OlegMishin/A500_8MB_ide/Doc/IMG_6086.jpg

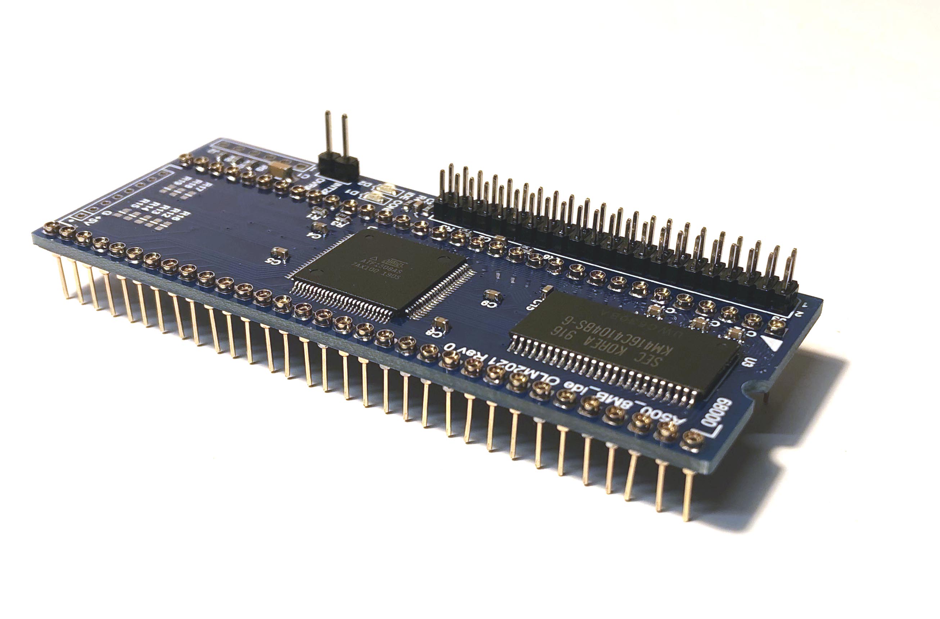
Doc/IMG_6086.jpg
