OlegMishin/A500_8MB_ide/Doc/IMG_6087.jpg

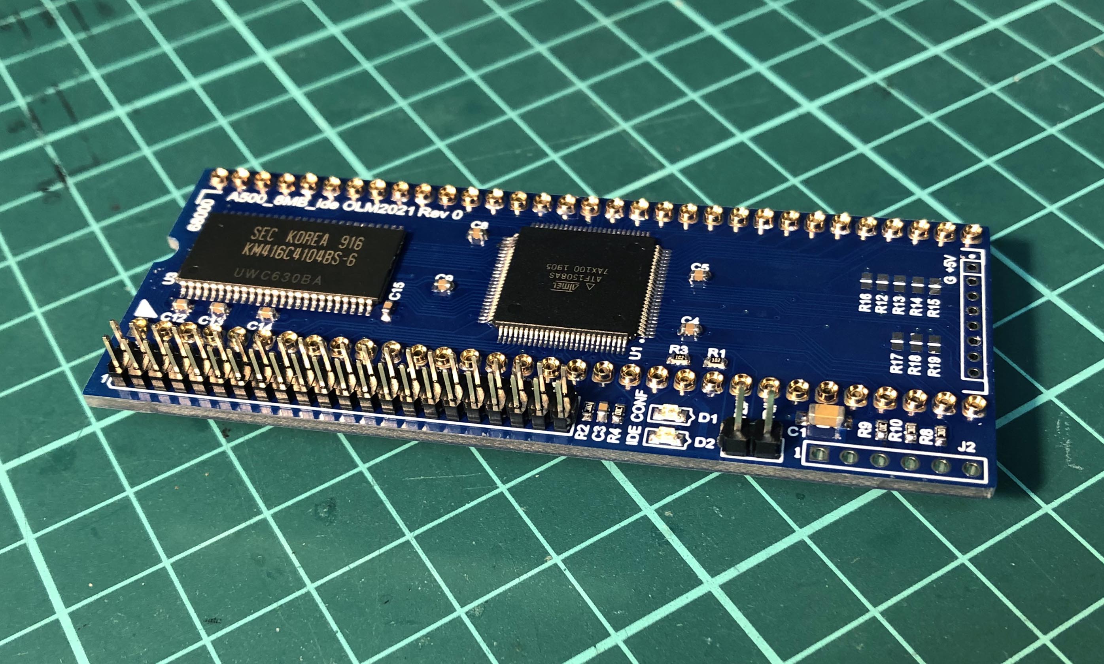
Doc/IMG_6087.jpg
