OlegMishin/A500_8MB_ide/Doc/3D_render.png

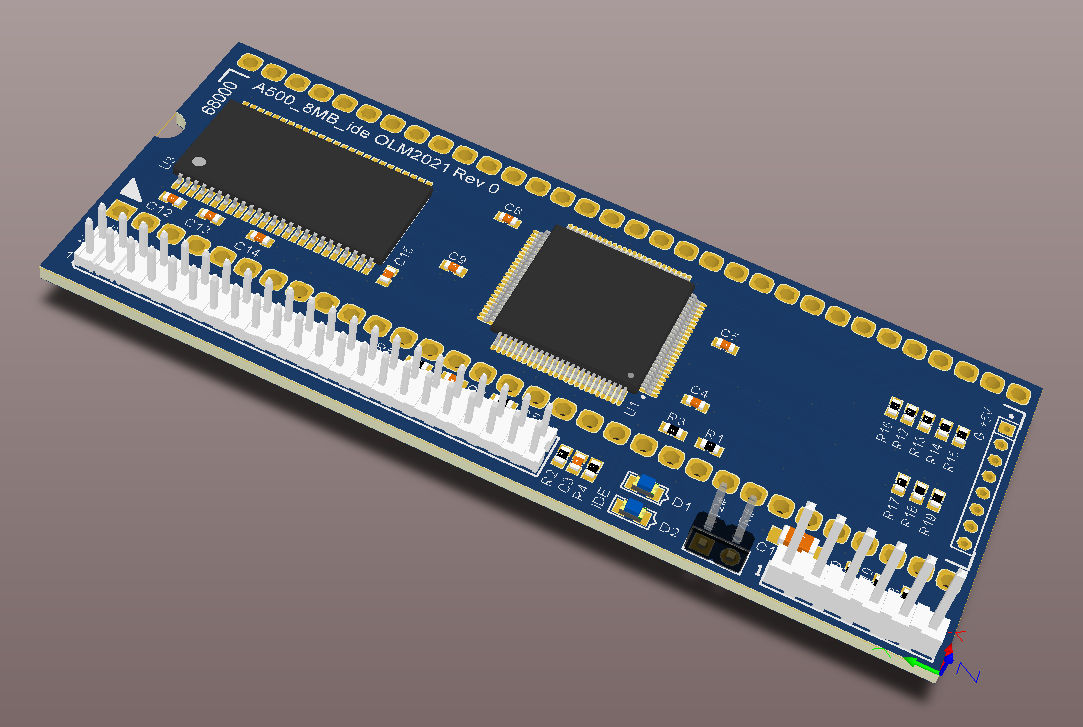
Doc/3D_render.png
