OlegMishin/A500_8MB_ide/Doc/IMG_5418.JPG

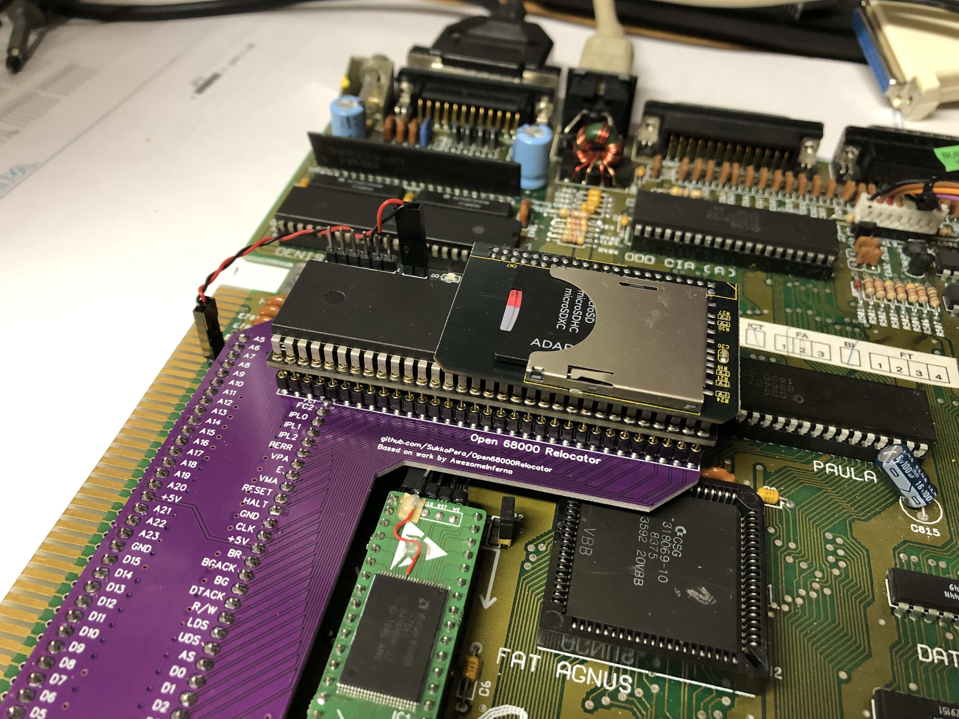
Doc/IMG_5418.JPG
