OlegMishin/A500_8MB_ide/Doc/IMG_5419.JPG

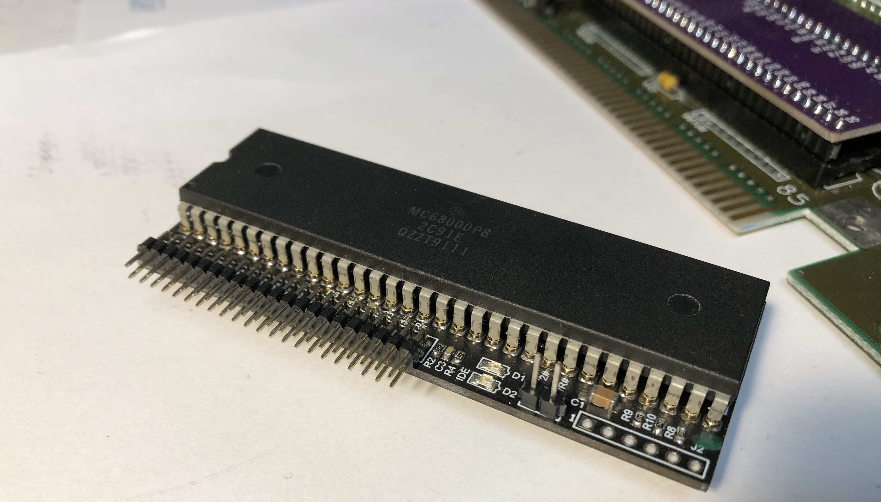
Doc/IMG_5419.JPG
