OlegMishin/A500_8MB_ide/Doc/IMG_5420.JPG

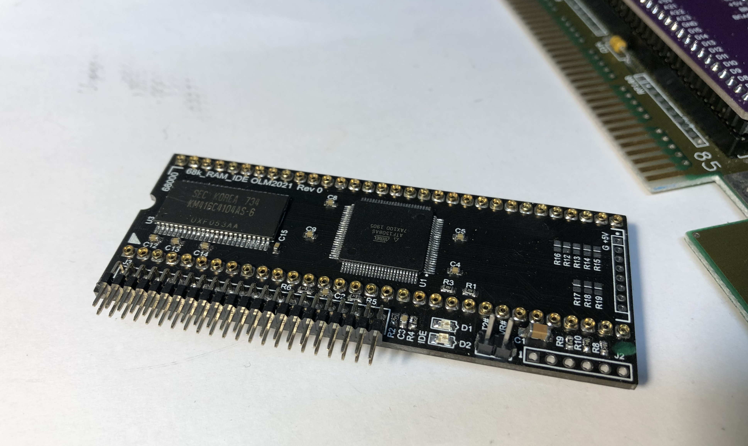
Doc/IMG_5420.JPG
