OlegMishin/A500_8MB_ide/pcb-rev0/A500_8MB_ide_rev0_BOM.PDF

Bill of Materials | A500_8MB_ide.PrjPcb
Revision | 0.0
Creation date | 15.10.2021 | 12:38:57
Print date | 15.10.2021 | 12:39:03
N п.п. | Quantity | Designator | #Column Name Error:Comment Value | | Description
1 | 1 | C1 | | 10uF 1206 | Ceramic capacitor SMD
2 | 14 | C2, C3, C4, C5, C6, C7, C8, C9, C10, C11, C12, C13, C14, C15 | | 100nF 0603 | Ceramic capacitor SMD
3 | 1 | D1 | | APTD3216MGC | LED Green
4 | 1 | D2 | | APTD3216EC | LED Red
5 | 1 | J1 | | Socket 1-pin x 64 | 64 combined socket/pins
6 | 1 | J2 | | PLS2-6 | Header, 6-Pin, 2mm pitch
7 | 1 | J3 | | PLD2-44 | Header, 22-Pin, Dual row, 2mm pitch
8 | 1 | J4 | | PLS-2 | Header, 2-Pin, 2.54mm pitch
9 | 1 | J5 | | PLS2-8 | Header, 8-Pin, 2mm pitch
10 2 | | R1, R3 | | 470 0603 | Resistor
11 7 | | R2, R4, R5, R6, R8, R9, R10 | | 10k 0603 | Resistor
12 2 | | R7, R11 | | 0R 0603 | Resistor (Jumper)
13 1 | | U1 | | ATF1508AS-7AX100 | 128 macrocells CPLD
14 1 | | U3 | | KM416C4104C | 4Mx16 EDO DRAM TSOP-II-50
