OlegMishin/A500_8MB_ide/(threads)

Thread 1 (2021-12-03):

Gerber

ozkanocakli, 2021-12-03:
Is there any chance to get Gerber files, I could not open cam file

best reagrds

OlegMishin, 2021-12-03:
Hi,
the Gerbers have been added to "pcb_rev0" folder.
BR,
Oleg

Closed 2021-12-03.

Thread 2 (2022-04-09):

Amiga 2000 Support?

salocinx, 2022-04-09:
Hi

Thanks for sharing this amazing project!

Does "no support for CFGIN/CFGOUT" mean it will conflict with other Zorro II Autoconfig boards in an Amiga 2000?

Regards
Nicolas

OlegMishin, 2022-04-09:
Hi Nicolas,

Thats right. As  have only A500, I had no chance to test other Autoconfig gevices.
But it is quite easy to route CFGOUT to one of the test pins, so the board can be first in a chain.

Cheers
Oleg

Thread 3 (2022-12-24):

CLPD

hueppee, 2022-12-24:
Hi, I can't find an ATF1508AS-7AX100. Is it possible to use an ATF1508ASL-25AU100 TQFP100 instead, that is the only one I found? Or are there any other IC's that I can use?

OlegMishin, 2022-12-25:
Hello,
In general, ASL-25 should be ok, as the design clocked from CPU's 7MHz. I have never tested it in this project, but in my other similar project "A500-FastRAM-8Mb" I used ASL-25 without any issues.
Based on that, I would recommend to use AS-10 or AS-15 in TQFP100 package (AU100 or AX100 ending) as I tested those speed grades. But ASL-20/25 also should work.

Regards
Oleg

hueppee, 2022-12-30:
Hi, thanks for your answer. I ordered an ATF1508AS-10AU100. Now I have a question, how I have to program the CPLD. On your board there are two connectors without labels. I labeled the JTAG connector, see the attached picture. Is that correct?
And how can I program the CPLD?
Here I found a description
[https://github.com/SukkoPera/OpenAmiga500FastRamExpansion/tree/master/firmware](https://github.com/SukkoPera/OpenAmiga500FastRamExpansion/tree/master/firmware)
Using a USB Blaster clone.
Or is it possible to use a raspberry pi? Which is done here for XC95xxXL CPLD's.
[https://github.com/LIV2/Bluster/blob/master/Programming.md](https://github.com/LIV2/Bluster/blob/master/Programming.md)

Best regards
Christian
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

OlegMishin, 2022-12-30:
Hi Christian,
Please refer to circuit diagram for actual JTAG pinout. It is on J2 as you found, but the pinout on your picture is not matching the circuit.
It should be:
1 - VCC
2 - TDO
3 - TCK
4 - TMS
5 - TDI
6 - GND
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

There are many ways for flashing the firmware. I use **Altera USB blaster** as below and OpenOCD software:
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

https://openocd.org/pages/getting-openocd.html

Just install OpenOCD and use this command to flash. It shall be executed in folder where *.svf firmware is located:
**"E:\openocd-v0.11.0\bin\openocd.exe" -f "E:\openocd-v0.11.0\scripts\interface\altera-usb-blaster.cfg" -c init -c "svf A500_8mb_ide.svf" -c "sleep 200" -c shutdown**
In my case OpenOCD installed in "E:\openocd-v0.11.0".

Regards
Oleg

rmueller83, 2023-01-14:
@hueppee did you have success?
I found some examples of using OpenOCD with a Raspberry here:
https://iosoft.blog/2019/01/28/raspberry-pi-openocd/
https://blog.wokwi.com/gdb-debugging-esp32-using-raspberry-pi/

OlegMishin, 2023-01-14:
I have never tried Raspberry as a debugger/loader cable.  As I have USB blaster, which is really cheap, no need for me to use anything else.
As an alternative FTDI FT232 adapter also should work.
Please check this article: https://www.hackup.net/2020/01/erasing-and-programming-the-atf1504-cpld/

hueppee, 2023-01-15:
Thanks for your answer! I ordered an USB blaster. Due to lack of time I will probably continue to solder the pcb in 2 weeks. I will report if everything works fine.

Best regards

Christian

hueppee, 2023-01-28:
Hi Oleg, my "USB Blaster" arrived and I installed openocd. But I have a problem to flash the  ATF1508AS.

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

Here the output of OpenOCD:

[out.txt](https://github.com/OlegMishin/A500_8MB_ide/files/10528406/out.txt)

OlegMishin, 2023-01-29:
Hi Christian,
There are some points in your assembly, which are not critical, but just to pay attention to:- First of all, the chip itself looks like counterfeit. The marking is different to chips I have (ordered at Mouser and Digikey). Have a look at the attached photo.- Not all decoupling capacitors are mounted. It is not critical for programming, but for normal operation it is mandatory to mount all of them.
USBblaster connection looks ok, but how do you supply the board? The USBblaster does not provide target supply voltage. In my setup I use an external power supply(red/black twisted wires on my photo). Please confirm, the board is powered. If no external power is applied, I got the same errors as you.
I have attached successful  CPLD programming log for your reference.
RegardsOleg

    On Saturday, January 28, 2023 at 11:25:08 PM GMT+1, hueppee ***@***.***> wrote:

Hi Oleg, my "USB Blaster" arrived and I installed openocd. But I have a problem to flash the ATF1508AS.

Here the output of OpenOCD:

out.txt

—
Reply to this email directly, view it on GitHub, or unsubscribe.
You are receiving this because you commented.Message ID: ***@***.***>

U:\work\Amiga\A500\A500_8MB_ide\firmware\rev1\output_files>rem bin-x64\openocd.exe -f scripts\interface\ftdi\um232h.cfg -c "adapter_khz 400" -c "transport select jtag" -c "jtag newtap ATF1504AS tap -irlen 3 -expected-id 0x0150403f" -c init -c "svf VC20FINAL-V3-2.svf" -c "sleep 200" -c shutdown

U:\work\Amiga\A500\A500_8MB_ide\firmware\rev1\output_files>"E:\openocd-v0.11.0\bin\openocd.exe" -f "E:\openocd-v0.11.0\scripts\interface\altera-usb-blaster.cfg" -c init -c "svf A500_8mb_ide.svf" -c "sleep 200" -c shutdown
Open On-Chip Debugger 0.11.0 (2021-03-07-12:52)
Licensed under GNU GPL v2
For bug reports, read
        http://openocd.org/doc/doxygen/bugs.html
Info : only one transport option; autoselect 'jtag'
Info : usb blaster interface using libftdi
Error: unable to get latency timer
Info : This adapter doesn't support configurable speed
Warn : There are no enabled taps.  AUTO PROBING MIGHT NOT WORK!!
Info : JTAG tap: auto0.tap tap/device found: 0x0150803f (mfg: 0x01f (Atmel), part: 0x1508, ver: 0x0)
Warn : AUTO auto0.tap - use "jtag newtap auto0 tap -irlen 3 -expected-id 0x0150803f"
Warn : gdb services need one or more targets defined
svf processing file: "A500_8mb_ide.svf"
TRST ABSENT;
ENDIR IDLE;
ENDDR IDLE;
HDR 0;
HIR 0;
TDR 0;
TIR 0;
RUNTEST 50021E-6 SEC;
STATE RESET;
STATE IDLE;
RUNTEST 50021E-6 SEC;
SIR 10 TDI (280);
SDR 10 TDI (1b9);
STATE IDLE;
SIR 10 TDI (059);
        MASK (ffffffff);
STATE IDLE;
SIR 10 TDI (2b3);
SIR 10 TDI (29e);
STATE IDLE;
RUNTEST 210001E-6 SEC;
SIR 10 TDI (2bf);
STATE IDLE;
STATE RESET;
RUNTEST 50001E-6 SEC;
STATE IDLE;
SIR 10 TDI (280);
SDR 10 TDI (000);
STATE IDLE;
RUNTEST 10001E-6 SEC;
STATE RESET;
RUNTEST 50021E-6 SEC;
RUNTEST 50021E-6 SEC;
STATE RESET;
STATE IDLE;
RUNTEST 50021E-6 SEC;
SIR 10 TDI (280);
SDR 10 TDI (1b9);
STATE IDLE;
SIR 10 TDI (2a1);
SDR 11 TDI (00c);
SIR 10 TDI (290);
SDR 326 TDI (0083234cb204c13add7f0000000000000000000000000000000000000000000000000000000000003f);
SIR 10 TDI (29e);
STATE IDLE;
RUNTEST 30001E-6 SEC;
SIR 10 TDI (2bf);
SIR 10 TDI (2a1);
SDR 11 TDI (00d);
SIR 10 TDI (290);
SDR 326 TDI (0083234cb204c13add7f0000000000000000000000000000000000000000000000000000000000003f);
SIR 10 TDI (29e);
STATE IDLE;
RUNTEST 30001E-6 SEC;
SIR 10 TDI (2bf);
SIR 10 TDI (2a1);
SDR 11 TDI (00e);
SIR 10 TDI (290);
SDR 326 TDI (0087234cf204c13bdf7f8000000000000000000000000000000000000000000000000000000000003f);
SIR 10 TDI (29e);
STATE IDLE;
RUNTEST 30001E-6 SEC;
SIR 10 TDI (2bf);
SIR 10 TDI (2a1);
SDR 11 TDI (00f);
SIR 10 TDI (290);
SDR 326 TDI (0087234cf204c13bdf7f8000000000000000000000000000000000000000000000000000000000003f);
SIR 10 TDI (29e);
STATE IDLE;
RUNTEST 30001E-6 SEC;
SIR 10 TDI (2bf);
SIR 10 TDI (2a1);
SDR 11 TDI (010);
SIR 10 TDI (290);
SDR 326 TDI (0087234cf204c13bdf7f8000000000000000000000000000000000000000000000000000000000003f);
SIR 10 TDI (29e);
STATE IDLE;
RUNTEST 30001E-6 SEC;
SIR 10 TDI (2bf);
SIR 10 TDI (2a1);
SDR 11 TDI (011);
SIR 10 TDI (290);
SDR 326 TDI (0087234cf204c13bdf7f8000000000000000000000000000000000000000000000000000000000003f);
SIR 10 TDI (29e);
STATE IDLE;
RUNTEST 30001E-6 SEC;
SIR 10 TDI (2bf);
SIR 10 TDI (2a1);
SDR 11 TDI (012);
SIR 10 TDI (290);
SDR 326 TDI (0087234cf204c13bdf7f8000000000000000000000000000000000000000000000000000000000003f);
SIR 10 TDI (29e);
STATE IDLE;
RUNTEST 30001E-6 SEC;
SIR 10 TDI (2bf);
SIR 10 TDI (2a1);
SDR 11 TDI (013);
SIR 10 TDI (290);
SDR 326 TDI (0087234cf204c13bdf7f8000000000000000000000000000000000000000000000000000000000003f);
SIR 10 TDI (29e);
STATE IDLE;
RUNTEST 30001E-6 SEC;
SIR 10 TDI (2bf);
SIR 10 TDI (2a1);
SDR 11 TDI (014);
SIR 10 TDI (290);
SDR 326 TDI (0087234cf204c13bdf7f8000000000000000000000000000000000000000000000000000000000003f);
SIR 10 TDI (29e);
STATE IDLE;
RUNTEST 30001E-6 SEC;
SIR 10 TDI (2bf);
SIR 10 TDI (2a1);
SDR 11 TDI (015);
SIR 10 TDI (290);
SDR 326 TDI (0087234cf204c13bdf7f8000000000000000000000000000000000000000000000000000000000003f);
SIR 10 TDI (29e);
STATE IDLE;
RUNTEST 30001E-6 SEC;
SIR 10 TDI (2bf);
SIR 10 TDI (2a1);
SDR 11 TDI (016);
SIR 10 TDI (290);
SDR 326 TDI (0087234cf204c13bdf7f8000000000000000000000000000000000000000000000000000000000003f);
SIR 10 TDI (29e);
STATE IDLE;
RUNTEST 30001E-6 SEC;
SIR 10 TDI (2bf);
SIR 10 TDI (2a1);
SDR 11 TDI (017);
SIR 10 TDI (290);
SDR 326 TDI (0087234cf204c13bdf7f8000000000000000000000000000000000000000000000000000000000003f);
SIR 10 TDI (29e);
STATE IDLE;
RUNTEST 30001E-6 SEC;
SIR 10 TDI (2bf);
SIR 10 TDI (2a1);
SDR 11 TDI (018);
SIR 10 TDI (290);
SDR 326 TDI (0087234cf204c13bdf7f8000000000000000000000000000000000000000000000000000000000003f);
SIR 10 TDI (29e);
STATE IDLE;
RUNTEST 30001E-6 SEC;
SIR 10 TDI (2bf);
SIR 10 TDI (2a1);
SDR 11 TDI (019);
SIR 10 TDI (290);
SDR 326 TDI (0087234cf204c13bdf7f8000000000000000000000000000000000000000000000000000000000003f);
SIR 10 TDI (29e);
STATE IDLE;
RUNTEST 30001E-6 SEC;
SIR 10 TDI (2bf);
SIR 10 TDI (2a1);
SDR 11 TDI (01a);
SIR 10 TDI (290);
SDR 326 TDI (0087234cf204c13bdf7f8000000000000000000000000000000000000000000000000000000000003f);
SIR 10 TDI (29e);
STATE IDLE;
RUNTEST 30001E-6 SEC;
SIR 10 TDI (2bf);
SIR 10 TDI (2a1);
SDR 11 TDI (01b);
SIR 10 TDI (290);
SDR 326 TDI (0087234cf204c13bdf7f8000000000000000000000000000000000000000000000000000000000003f);
SIR 10 TDI (29e);
STATE IDLE;
RUNTEST 30001E-6 SEC;
SIR 10 TDI (2bf);
SIR 10 TDI (2a1);
SDR 11 TDI (01c);
SIR 10 TDI (290);
SDR 326 TDI (00830244b2044102dd7f0000000000000000000000000000000000000000000000000000000000003f);
SIR 10 TDI (29e);
STATE IDLE;
RUNTEST 30001E-6 SEC;
SIR 10 TDI (2bf);
SIR 10 TDI (2a1);
SDR 11 TDI (01d);
SIR 10 TDI (290);
SDR 326 TDI (0087234cf204c13bdf7f8000000000000000000000000000000000000000000000000000000000003f);
SIR 10 TDI (29e);
STATE IDLE;
RUNTEST 30001E-6 SEC;
SIR 10 TDI (2bf);
SIR 10 TDI (2a1);
SDR 11 TDI (01e);
SIR 10 TDI (290);
SDR 326 TDI (0087234cf204c13bdf7f8000000000000000000000000000000000000000000000000000000000003f);
SIR 10 TDI (29e);
STATE IDLE;
RUNTEST 30001E-6 SEC;
SIR 10 TDI (2bf);
SIR 10 TDI (2a1);
SDR 11 TDI (01f);
SIR 10 TDI (290);
SDR 326 TDI (0087234cf204c13bdf7f8000000000000000000000000000000000000000000000000000000000003f);
SIR 10 TDI (29e);
STATE IDLE;
RUNTEST 30001E-6 SEC;
SIR 10 TDI (2bf);
SIR 10 TDI (2a1);
SDR 11 TDI (020);
SIR 10 TDI (290);
SDR 326 TDI (0087234cf204c13bdf7f8000000000000000000000000000000000000000000000000000000000003f);
SIR 10 TDI (29e);
STATE IDLE;
RUNTEST 30001E-6 SEC;
SIR 10 TDI (2bf);
SIR 10 TDI (2a1);
SDR 11 TDI (021);
SIR 10 TDI (290);
SDR 326 TDI (0087234cf204c13bdf7f8000000000000000000000000000000000000000000000000000000000003f);
SIR 10 TDI (29e);
STATE IDLE;
RUNTEST 30001E-6 SEC;
SIR 10 TDI (2bf);
SIR 10 TDI (2a1);
SDR 11 TDI (022);
SIR 10 TDI (290);
SDR 326 TDI (0087234cf204c13bdf7f8000000000000000000000000000000000000000000000000000000000003f);
SIR 10 TDI (29e);
STATE IDLE;
RUNTEST 30001E-6 SEC;
SIR 10 TDI (2bf);
SIR 10 TDI (2a1);
SDR 11 TDI (023);
SIR 10 TDI (290);
SDR 326 TDI (0087234cf204c13bdf7f8000000000000000000000000000000000000000000000000000000000003f);
SIR 10 TDI (29e);
STATE IDLE;
RUNTEST 30001E-6 SEC;
SIR 10 TDI (2bf);
SIR 10 TDI (2a1);
SDR 11 TDI (024);
SIR 10 TDI (290);
SDR 326 TDI (0087214cf204c03bdf5e8000000000000000000000000000000000000000000000000000000000003f);
SIR 10 TDI (29e);
STATE IDLE;
RUNTEST 30001E-6 SEC;
SIR 10 TDI (2bf);
SIR 10 TDI (2a1);
SDR 11 TDI (025);
SIR 10 TDI (290);
SDR 326 TDI (0087234cf204c13bdf7d8000000000000000000000000000000000000000000000000000000000003f);
SIR 10 TDI (29e);
STATE IDLE;
RUNTEST 30001E-6 SEC;
SIR 10 TDI (2bf);
SIR 10 TDI (2a1);
SDR 11 TDI (026);
SIR 10 TDI (290);
SDR 326 TDI (0084224c4204c139127f8000000000000000000000000000000000000000000000000000000000003f);
SIR 10 TDI (29e);
STATE IDLE;
RUNTEST 30001E-6 SEC;
SIR 10 TDI (2bf);
SIR 10 TDI (2a1);
SDR 11 TDI (027);
SIR 10 TDI (290);
SDR 326 TDI (0087034cf204c13bdf0c8000000000000000000000000000000000000000000000000000000000003f);
SIR 10 TDI (29e);
STATE IDLE;
RUNTEST 30001E-6 SEC;
SIR 10 TDI (2bf);
SIR 10 TDI (2a1);
SDR 11 TDI (028);
SIR 10 TDI (290);
SDR 326 TDI (00830244b2044112dd7f0000000000000000000000000000000000000000000000000000000000003f);
SIR 10 TDI (29e);
STATE IDLE;
RUNTEST 30001E-6 SEC;
SIR 10 TDI (2bf);
SIR 10 TDI (2a1);
SDR 11 TDI (029);
SIR 10 TDI (290);
SDR 326 TDI (0087234cf204c13bdf7f8000000000000000000000000000000000000000000000000000000000003f);
SIR 10 TDI (29e);
STATE IDLE;
RUNTEST 30001E-6 SEC;
SIR 10 TDI (2bf);
SIR 10 TDI (2a1);
SDR 11 TDI (02a);
SIR 10 TDI (290);
SDR 326 TDI (00830244b2044102dd7f0000000000000000000000000000000000000000000000000000000000003f);
SIR 10 TDI (29e);
STATE IDLE;
RUNTEST 30001E-6 SEC;
SIR 10 TDI (2bf);
SIR 10 TDI (2a1);
SDR 11 TDI (02b);
SIR 10 TDI (290);
SDR 326 TDI (0087234cf204c13bdf7f8000000000000000000000000000000000000000000000000000000000003f);
SIR 10 TDI (29e);
STATE IDLE;
RUNTEST 30001E-6 SEC;
SIR 10 TDI (2bf);
SIR 10 TDI (2a1);
SDR 11 TDI (02c);
SIR 10 TDI (290);
SDR 326 TDI (0007214cf204c13bdf6f8000000000000000000000000000000000000000000000000000000000003f);
SIR 10 TDI (29e);
STATE IDLE;
RUNTEST 30001E-6 SEC;
SIR 10 TDI (2bf);
SIR 10 TDI (2a1);
SDR 11 TDI (02d);
SIR 10 TDI (290);
SDR 326 TDI (0087234cf204c13bdf7f8000000000000000000000000000000000000000000000000000000000003f);
SIR 10 TDI (29e);
STATE IDLE;
RUNTEST 30001E-6 SEC;
SIR 10 TDI (2bf);
SIR 10 TDI (2a1);
SDR 11 TDI (02e);
SIR 10 TDI (290);
SDR 326 TDI (0087234cf204c13bdf7f8000000000000000000000000000000000000000000000000000000000003f);
SIR 10 TDI (29e);
STATE IDLE;
RUNTEST 30001E-6 SEC;
SIR 10 TDI (2bf);
SIR 10 TDI (2a1);
SDR 11 TDI (02f);
SIR 10 TDI (290);
SDR 326 TDI (0087234cf200c13bdf7f8000000000000000000000000000000000000000000000000000000000003f);
SIR 10 TDI (29e);
STATE IDLE;
RUNTEST 30001E-6 SEC;
SIR 10 TDI (2bf);
SIR 10 TDI (2a1);
SDR 11 TDI (030);
SIR 10 TDI (290);
SDR 326 TDI (0087234cf204c13bdf7f8000000000000000000000000000000000000000000000000000000000003f);
SIR 10 TDI (29e);
STATE IDLE;
RUNTEST 30001E-6 SEC;
SIR 10 TDI (2bf);
SIR 10 TDI (2a1);
SDR 11 TDI (031);
SIR 10 TDI (290);
SDR 326 TDI (0087234cf004c13bdf7f8000000000000000000000000000000000000000000000000000000000003f);
SIR 10 TDI (29e);
STATE IDLE;
RUNTEST 30001E-6 SEC;
SIR 10 TDI (2bf);
SIR 10 TDI (2a1);
SDR 11 TDI (032);
SIR 10 TDI (290);
SDR 326 TDI (0085234c7204c13bdf7f8000000000000000000000000000000000000000000000000000000000003f);
SIR 10 TDI (29e);
STATE IDLE;
RUNTEST 30001E-6 SEC;
SIR 10 TDI (2bf);
SIR 10 TDI (2a1);
SDR 11 TDI (033);
SIR 10 TDI (290);
SDR 326 TDI (0086234ce204c13bdf7f8000000000000000000000000000000000000000000000000000000000003f);
SIR 10 TDI (29e);
STATE IDLE;
RUNTEST 30001E-6 SEC;
SIR 10 TDI (2bf);
SIR 10 TDI (2a1);
SDR 11 TDI (034);
SIR 10 TDI (290);
SDR 326 TDI (0087234cf204c13bdf7f8000000000000000000000000000000000000000000000000000000000003f);
SIR 10 TDI (29e);
STATE IDLE;
RUNTEST 30001E-6 SEC;
SIR 10 TDI (2bf);
SIR 10 TDI (2a1);
SDR 11 TDI (035);
SIR 10 TDI (290);
SDR 326 TDI (0087234cf204c13bdf7f8000000000000000000000000000000000000000000000000000000000003f);
SIR 10 TDI (29e);
STATE IDLE;
RUNTEST 30001E-6 SEC;
SIR 10 TDI (2bf);
SIR 10 TDI (2a1);
SDR 11 TDI (036);
SIR 10 TDI (290);
SDR 326 TDI (0087234cf204c13bdf7f8000000000000000000000000000000000000000000000000000000000003f);
SIR 10 TDI (29e);
STATE IDLE;
RUNTEST 30001E-6 SEC;
SIR 10 TDI (2bf);
SIR 10 TDI (2a1);
SDR 11 TDI (037);
SIR 10 TDI (290);
SDR 326 TDI (0083224cb204c13add7f0000000000000000000000000000000000000000000000000000000000003f);
SIR 10 TDI (29e);
STATE IDLE;
RUNTEST 30001E-6 SEC;
SIR 10 TDI (2bf);
SIR 10 TDI (2a1);
SDR 11 TDI (038);
SIR 10 TDI (290);
SDR 326 TDI (0087234cf204c13bda4f8000000000000000000000000000000000000000000000000000000000003f);
SIR 10 TDI (29e);
STATE IDLE;
RUNTEST 30001E-6 SEC;
SIR 10 TDI (2bf);
SIR 10 TDI (2a1);
SDR 11 TDI (039);
SIR 10 TDI (290);
SDR 326 TDI (0087234cf204c13bcf7f8000000000000000000000000000000000000000000000000000000000003f);
SIR 10 TDI (29e);
STATE IDLE;
RUNTEST 30001E-6 SEC;
SIR 10 TDI (2bf);
SIR 10 TDI (2a1);
SDR 11 TDI (03a);
SIR 10 TDI (290);
SDR 326 TDI (0084234c4204c139167b8000000000000000000000000000000000000000000000000000000000003f);
SIR 10 TDI (29e);
STATE IDLE;
RUNTEST 30001E-6 SEC;
SIR 10 TDI (2bf);
SIR 10 TDI (2a1);
SDR 11 TDI (03b);
SIR 10 TDI (290);
SDR 326 TDI (00870244f2044123db048000000000000000000000000000000000000000000000000000000000003f);
SIR 10 TDI (29e);
STATE IDLE;
RUNTEST 30001E-6 SEC;
SIR 10 TDI (2bf);
SIR 10 TDI (2a1);
SDR 11 TDI (03c);
SIR 10 TDI (290);
SDR 326 TDI (0087234cf204c12bdf7f8000000000000000000000000000000000000000000000000000000000003f);
SIR 10 TDI (29e);
STATE IDLE;
RUNTEST 30001E-6 SEC;
SIR 10 TDI (2bf);
SIR 10 TDI (2a1);
SDR 11 TDI (03d);
SIR 10 TDI (290);
SDR 326 TDI (00830244b204411add7f0000000000000000000000000000000000000000000000000000000000003f);
SIR 10 TDI (29e);
STATE IDLE;
RUNTEST 30001E-6 SEC;
SIR 10 TDI (2bf);
SIR 10 TDI (2a1);
SDR 11 TDI (03e);
SIR 10 TDI (290);
SDR 326 TDI (0087234cf204c13bdf7f8000000000000000000000000000000000000000000000000000000000003f);
SIR 10 TDI (29e);
STATE IDLE;
RUNTEST 30001E-6 SEC;
SIR 10 TDI (2bf);
SIR 10 TDI (2a1);
SDR 11 TDI (03f);
SIR 10 TDI (290);
SDR 326 TDI (00830244b2044102dd7f0000000000000000000000000000000000000000000000000000000000003f);
SIR 10 TDI (29e);
STATE IDLE;
RUNTEST 30001E-6 SEC;
SIR 10 TDI (2bf);
SIR 10 TDI (2a1);
SDR 11 TDI (040);
SIR 10 TDI (290);
SDR 326 TDI (0087234cf204c13bdf7f8000000000000000000000000000000000000000000000000000000000003f);
SIR 10 TDI (29e);
STATE IDLE;
RUNTEST 30001E-6 SEC;
SIR 10 TDI (2bf);
SIR 10 TDI (2a1);
SDR 11 TDI (041);
SIR 10 TDI (290);
SDR 326 TDI (0087234cf204c13bdf7f8000000000000000000000000000000000000000000000000000000000003f);
SIR 10 TDI (29e);
STATE IDLE;
RUNTEST 30001E-6 SEC;
SIR 10 TDI (2bf);
SIR 10 TDI (2a1);
SDR 11 TDI (042);
SIR 10 TDI (290);
SDR 326 TDI (0087230cf204c03bdb7f8000000000000000000000000000000000000000000000000000000000003f);
SIR 10 TDI (29e);
STATE IDLE;
RUNTEST 30001E-6 SEC;
SIR 10 TDI (2bf);
SIR 10 TDI (2a1);
SDR 11 TDI (043);
SIR 10 TDI (290);
SDR 326 TDI (0087234cf204c13bdf7f8000000000000000000000000000000000000000000000000000000000003f);
SIR 10 TDI (29e);
STATE IDLE;
RUNTEST 30001E-6 SEC;
SIR 10 TDI (2bf);
SIR 10 TDI (2a1);
SDR 11 TDI (044);
SIR 10 TDI (290);
SDR 326 TDI (0087234cf204c1395f7f8000000000000000000000000000000000000000000000000000000000003f);
SIR 10 TDI (29e);
STATE IDLE;
RUNTEST 30001E-6 SEC;
SIR 10 TDI (2bf);
SIR 10 TDI (2a1);
SDR 11 TDI (045);
SIR 10 TDI (290);
SDR 326 TDI (0087234cf204c13b9e7f8000000000000000000000000000000000000000000000000000000000003f);
SIR 10 TDI (29e);
STATE IDLE;
RUNTEST 30001E-6 SEC;
SIR 10 TDI (2bf);
SIR 10 TDI (2a1);
SDR 11 TDI (046);
SIR 10 TDI (290);
SDR 326 TDI (0087234cf204c13bdf7f8000000000000000000000000000000000000000000000000000000000003f);
SIR 10 TDI (29e);
STATE IDLE;
RUNTEST 30001E-6 SEC;
SIR 10 TDI (2bf);
SIR 10 TDI (2a1);
SDR 11 TDI (047);
SIR 10 TDI (290);
SDR 326 TDI (0087234cf204c13bdf7f8000000000000000000000000000000000000000000000000000000000003f);
SIR 10 TDI (29e);
STATE IDLE;
RUNTEST 30001E-6 SEC;
SIR 10 TDI (2bf);
SIR 10 TDI (2a1);
SDR 11 TDI (048);
SIR 10 TDI (290);
SDR 326 TDI (00872344f204413bdf7f8000000000000000000000000000000000000000000000000000000000003f);
SIR 10 TDI (29e);
STATE IDLE;
RUNTEST 30001E-6 SEC;
SIR 10 TDI (2bf);
SIR 10 TDI (2a1);
SDR 11 TDI (049);
SIR 10 TDI (290);
SDR 326 TDI (0087234cf204c13bdf7f8000000000000000000000000000000000000000000000000000000000003f);
SIR 10 TDI (29e);
STATE IDLE;
RUNTEST 30001E-6 SEC;
SIR 10 TDI (2bf);
SIR 10 TDI (2a1);
SDR 11 TDI (04a);
SIR 10 TDI (290);
SDR 326 TDI (0087234cf204c13bdf7f8000000000000000000000000000000000000000000000000000000000003f);
SIR 10 TDI (29e);
STATE IDLE;
RUNTEST 30001E-6 SEC;
SIR 10 TDI (2bf);
SIR 10 TDI (2a1);
SDR 11 TDI (04b);
SIR 10 TDI (290);
SDR 326 TDI (0087234cf204c13bdf7f8000000000000000000000000000000000000000000000000000000000003f);
SIR 10 TDI (29e);
STATE IDLE;
RUNTEST 30001E-6 SEC;
SIR 10 TDI (2bf);
SIR 10 TDI (2a1);
SDR 11 TDI (04c);
SIR 10 TDI (290);
SDR 326 TDI (0087234cf204c13bc73f8000000000000000000000000000000000000000000000000000000000003f);
SIR 10 TDI (29e);
STATE IDLE;
RUNTEST 30001E-6 SEC;
SIR 10 TDI (2bf);
SIR 10 TDI (2a1);
SDR 11 TDI (04d);
SIR 10 TDI (290);
SDR 326 TDI (0087234cf204c13bdf7f8000000000000000000000000000000000000000000000000000000000003f);
SIR 10 TDI (29e);
STATE IDLE;
RUNTEST 30001E-6 SEC;
SIR 10 TDI (2bf);
SIR 10 TDI (2a1);
SDR 11 TDI (04e);
SIR 10 TDI (290);
SDR 326 TDI (0087234cf204c13bdf7f8000000000000000000000000000000000000000000000000000000000003f);
SIR 10 TDI (29e);
STATE IDLE;
RUNTEST 30001E-6 SEC;
SIR 10 TDI (2bf);
SIR 10 TDI (2a1);
SDR 11 TDI (04f);
SIR 10 TDI (290);
SDR 326 TDI (0087214cf204c13bdf7f8000000000000000000000000000000000000000000000000000000000003f);
SIR 10 TDI (29e);
STATE IDLE;
RUNTEST 30001E-6 SEC;
SIR 10 TDI (2bf);
SIR 10 TDI (2a1);
SDR 11 TDI (050);
SIR 10 TDI (290);
SDR 326 TDI (0087224cf204c13bdf7b8000000000000000000000000000000000000000000000000000000000003f);
SIR 10 TDI (29e);
STATE IDLE;
RUNTEST 30001E-6 SEC;
SIR 10 TDI (2bf);
SIR 10 TDI (2a1);
SDR 11 TDI (051);
SIR 10 TDI (290);
SDR 326 TDI (00870344f204413bdf778000000000000000000000000000000000000000000000000000000000003f);
SIR 10 TDI (29e);
STATE IDLE;
RUNTEST 30001E-6 SEC;
SIR 10 TDI (2bf);
SIR 10 TDI (2a1);
SDR 11 TDI (052);
SIR 10 TDI (290);
SDR 326 TDI (0087234c5204c13b9f7f8000000000000000000000000000000000000000000000000000000000003f);
SIR 10 TDI (29e);
STATE IDLE;
RUNTEST 30001E-6 SEC;
SIR 10 TDI (2bf);
SIR 10 TDI (2a1);
SDR 11 TDI (053);
SIR 10 TDI (290);
SDR 326 TDI (0087234ce204c139df7f8000000000000000000000000000000000000000000000000000000000003f);
SIR 10 TDI (29e);
STATE IDLE;
RUNTEST 30001E-6 SEC;
SIR 10 TDI (2bf);
SIR 10 TDI (2a1);
SDR 11 TDI (054);
SIR 10 TDI (290);
SDR 326 TDI (0087234cf204c13bdf7f8000000000000000000000000000000000000000000000000000000000003f);
SIR 10 TDI (29e);
STATE IDLE;
RUNTEST 30001E-6 SEC;
SIR 10 TDI (2bf);
SIR 10 TDI (2a1);
SDR 11 TDI (055);
SIR 10 TDI (290);
SDR 326 TDI (0087034cf204c13bdf7f8000000000000000000000000000000000000000000000000000000000003f);
SIR 10 TDI (29e);
STATE IDLE;
RUNTEST 30001E-6 SEC;
SIR 10 TDI (2bf);
SIR 10 TDI (2a1);
SDR 11 TDI (056);
SIR 10 TDI (290);
SDR 326 TDI (00862344e204c13b9a4f8000000000000000000000000000000000000000000000000000000000003f);
SIR 10 TDI (29e);
STATE IDLE;
RUNTEST 30001E-6 SEC;
SIR 10 TDI (2bf);
SIR 10 TDI (2a1);
SDR 11 TDI (057);
SIR 10 TDI (290);
SDR 326 TDI (0085224cd204413b573c8000000000000000000000000000000000000000000000000000000000003f);
SIR 10 TDI (29e);
STATE IDLE;
RUNTEST 30001E-6 SEC;
SIR 10 TDI (2bf);
SIR 10 TDI (2a1);
SDR 11 TDI (058);
SIR 10 TDI (290);
SDR 326 TDI (0087234cf204c13bdf1c8000000000000000000000000000000000000000000000000000000000003f);
SIR 10 TDI (29e);
STATE IDLE;
RUNTEST 30001E-6 SEC;
SIR 10 TDI (2bf);
SIR 10 TDI (2a1);
SDR 11 TDI (059);
SIR 10 TDI (290);
SDR 326 TDI (0084224c4204c139126f8000000000000000000000000000000000000000000000000000000000003f);
SIR 10 TDI (29e);
STATE IDLE;
RUNTEST 30001E-6 SEC;
SIR 10 TDI (2bf);
SIR 10 TDI (2a1);
SDR 11 TDI (05a);
SIR 10 TDI (290);
SDR 326 TDI (00830244b2044102dd7f0000000000000000000000000000000000000000000000000000000000003f);
SIR 10 TDI (29e);
STATE IDLE;
RUNTEST 30001E-6 SEC;
SIR 10 TDI (2bf);
SIR 10 TDI (2a1);
SDR 11 TDI (05b);
SIR 10 TDI (290);
SDR 326 TDI (0087234cf204c13bdf7f8000000000000000000000000000000000000000000000000000000000003f);
SIR 10 TDI (29e);
STATE IDLE;
RUNTEST 30001E-6 SEC;
SIR 10 TDI (2bf);
SIR 10 TDI (2a1);
SDR 11 TDI (05c);
SIR 10 TDI (290);
SDR 326 TDI (0087230cf204c13bdf7d8000000000000000000000000000000000000000000000000000000000003f);
SIR 10 TDI (29e);
STATE IDLE;
RUNTEST 30001E-6 SEC;
SIR 10 TDI (2bf);
SIR 10 TDI (2a1);
SDR 11 TDI (05d);
SIR 10 TDI (290);
SDR 326 TDI (0087234cf204c13bdf7e8000000000000000000000000000000000000000000000000000000000003f);
SIR 10 TDI (29e);
STATE IDLE;
RUNTEST 30001E-6 SEC;
SIR 10 TDI (2bf);
SIR 10 TDI (2a1);
SDR 11 TDI (05e);
SIR 10 TDI (290);
SDR 326 TDI (00830244b2044102dd7f0000000000000000000000000000000000000000000000000000000000003f);
SIR 10 TDI (29e);
STATE IDLE;
RUNTEST 30001E-6 SEC;
SIR 10 TDI (2bf);
SIR 10 TDI (2a1);
SDR 11 TDI (05f);
SIR 10 TDI (290);
SDR 326 TDI (0087234cf204c13bdf7f8000000000000000000000000000000000000000000000000000000000003f);
SIR 10 TDI (29e);
STATE IDLE;
RUNTEST 30001E-6 SEC;
SIR 10 TDI (2bf);
SIR 10 TDI (2a1);
SDR 11 TDI (060);
SIR 10 TDI (290);
SDR 326 TDI (00872348f204813bdf7f8000000000000000000000000000000000000000000000000000000000003f);
SIR 10 TDI (29e);
STATE IDLE;
RUNTEST 30001E-6 SEC;
SIR 10 TDI (2bf);
SIR 10 TDI (2a1);
SDR 11 TDI (061);
SIR 10 TDI (290);
SDR 326 TDI (0083224cb204c11add7f0000000000000000000000000000000000000000000000000000000000003f);
SIR 10 TDI (29e);
STATE IDLE;
RUNTEST 30001E-6 SEC;
SIR 10 TDI (2bf);
SIR 10 TDI (2a1);
SDR 11 TDI (062);
SIR 10 TDI (290);
SDR 326 TDI (0087234cf204c13bdf7f8000000000000000000000000000000000000000000000000000000000003f);
SIR 10 TDI (29e);
STATE IDLE;
RUNTEST 30001E-6 SEC;
SIR 10 TDI (2bf);
SIR 10 TDI (2a1);
SDR 11 TDI (063);
SIR 10 TDI (290);
SDR 326 TDI (0087234cf204c13bdf7f8000000000000000000000000000000000000000000000000000000000003f);
SIR 10 TDI (29e);
STATE IDLE;
RUNTEST 30001E-6 SEC;
SIR 10 TDI (2bf);
SIR 10 TDI (2a1);
SDR 11 TDI (064);
SIR 10 TDI (290);
SDR 326 TDI (0087234cf204c13bdf7f8000000000000000000000000000000000000000000000000000000000003f);
SIR 10 TDI (29e);
STATE IDLE;
RUNTEST 30001E-6 SEC;
SIR 10 TDI (2bf);
SIR 10 TDI (2a1);
SDR 11 TDI (065);
SIR 10 TDI (290);
SDR 326 TDI (0087234cf204c13bdf7f8000000000000000000000000000000000000000000000000000000000003f);
SIR 10 TDI (29e);
STATE IDLE;
RUNTEST 30001E-6 SEC;
SIR 10 TDI (2bf);
SIR 10 TDI (2a1);
SDR 11 TDI (066);
SIR 10 TDI (290);
SDR 326 TDI (0087234cf204c13bdf7f8000000000000000000000000000000000000000000000000000000000003f);
SIR 10 TDI (29e);
STATE IDLE;
RUNTEST 30001E-6 SEC;
SIR 10 TDI (2bf);
SIR 10 TDI (2a1);
SDR 11 TDI (067);
SIR 10 TDI (290);
SDR 326 TDI (0087234cf204c13bdf7f8000000000000000000000000000000000000000000000000000000000003f);
SIR 10 TDI (29e);
STATE IDLE;
RUNTEST 30001E-6 SEC;
SIR 10 TDI (2bf);
SIR 10 TDI (2a1);
SDR 11 TDI (068);
SIR 10 TDI (290);
SDR 326 TDI (0087234cf204c13bdf7f8000000000000000000000000000000000000000000000000000000000003f);
SIR 10 TDI (29e);
STATE IDLE;
RUNTEST 30001E-6 SEC;
SIR 10 TDI (2bf);
SIR 10 TDI (2a1);
SDR 11 TDI (069);
SIR 10 TDI (290);
SDR 326 TDI (0087234cf204c13bdf7f8000000000000000000000000000000000000000000000000000000000003f);
SIR 10 TDI (29e);
STATE IDLE;
RUNTEST 30001E-6 SEC;
SIR 10 TDI (2bf);
SIR 10 TDI (2a1);
SDR 11 TDI (06a);
SIR 10 TDI (290);
SDR 326 TDI (0087234cf204c13bdf7f8000000000000000000000000000000000000000000000000000000000003f);
SIR 10 TDI (29e);
STATE IDLE;
RUNTEST 30001E-6 SEC;
SIR 10 TDI (2bf);
SIR 10 TDI (2a1);
SDR 11 TDI (06b);
SIR 10 TDI (290);
SDR 326 TDI (0087234cf204c13bdf7f8000000000000000000000000000000000000000000000000000000000003f);
SIR 10 TDI (29e);
STATE IDLE;
RUNTEST 30001E-6 SEC;
SIR 10 TDI (2bf);
STATE IDLE;
SIR 10 TDI (2a1);
SDR 11 TDI (080);
SIR 10 TDI (290);
SDR 326 TDI (00010000020c000000020003300c030c03300f03c00f2c00020403300c033e0fbdcf021ca730ca133f);
SIR 10 TDI (29e);
STATE IDLE;
RUNTEST 30001E-6 SEC;
SIR 10 TDI (2bf);
SIR 10 TDI (2a1);
SDR 11 TDI (081);
SIR 10 TDI (290);
SDR 326 TDI (00010000020c000000020003300c030c03300f03c00f2c00020403300c033e0fbdcf021ca730ca133f);
SIR 10 TDI (29e);
STATE IDLE;
RUNTEST 30001E-6 SEC;
SIR 10 TDI (2bf);
SIR 10 TDI (2a1);
SDR 11 TDI (082);
SIR 10 TDI (290);
SDR 326 TDI (00010000020c000000020003300c030c03300f03c00f2c00020403300c033e0fbdcf021ca730ca133f);
SIR 10 TDI (29e);
STATE IDLE;
RUNTEST 30001E-6 SEC;
SIR 10 TDI (2bf);
SIR 10 TDI (2a1);
SDR 11 TDI (083);
SIR 10 TDI (290);
SDR 326 TDI (00010000020c000000020003300c030c03300f03c00f2c00020403300c033e0fbdcf021ca730ca133f);
SIR 10 TDI (29e);
STATE IDLE;
RUNTEST 30001E-6 SEC;
SIR 10 TDI (2bf);
SIR 10 TDI (2a1);
SDR 11 TDI (084);
SIR 10 TDI (290);
SDR 326
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

Thread 4 (2023-05-15):

Your feedback would be appreciated :)

OlegMishin, 2023-05-15:
If sombody has a positive build experience, I would appreciate if you write a couple of words here.
Thanks!

ceztko, 2023-05-15:
I'm sorry, I can't provide any feedback but I ask you how your project compares to LIV2's [GottaGoFastRAM](https://github.com/LIV2/GottaGoFastRAM) (which is also based on RAM68K?) + IDE68K. It seems you redesigned the 2 RAM+IDE projects to mount on a single PCB and you have a 44 pin header while I believe IDE68K has a 40 pin header (do you also carry power?).  Is your project sold from any store? Because I just bought a GottaGoFastRAM+IDE68K from [AmigaStore.eu](https://amigastore.eu/en/929-ide68k-gottago-fastram-8mb.html) and I still have to install it and I'm already disappointed because your project look better :).

OlegMishin, 2023-05-16:
Hi Francesco,
thanks for your comments. I can not say how much in details my design differs to GottaGoFastRAM. But comparing source codes I found one weakness of my board - it doesn't support CDTV. This I will try to improve.
Regarding IDE connector, that is right, the 44pin connector has 5V supply pins, so it can power a small HDD. I use CF to IDE or SD to IDE adapters.
My project is not presented in any store. Sometimes I sell some of my samples on eBay or Kleinanzeigen (I'm in Germany) but not on a regular basis. At the moment I have a couple of free A500_8MB_ide2 boards. This is the next generation of the project. If you are interested, please contact me via linkedin or I can drop you an email which is on your Github page.
Regards
Oleg

ceztko, 2023-05-16:
Sorry, I have the other board to try right now, but I will pass by here from time to time to check for news. Of course if you find a shop/sponsor it would be very useful to receive more feedback (maybe you could contact Lotharek's Lair?). I also recommend you to ensure compatibility with AmigaOS/Kickstart 3.2.x. You know, that's the trend now...

I give you another possible suggestion: would it be possible in the current form factor to offer freezer like features? For example ACA500 from Individual Computer comes with Whdload Quit-key support (that otherwise would require a 68010+ CPU), and HRTmon/AR3. Would it be possible to implement those on top of the CPU socket (like your board), as opposed to be a full external expansion?

krug3rf, 2023-06-02:
Hi @OlegMishin :)
No stock on digikey, mouser, etc.
X9572XL can't be used (more easy to ordering) like GottaGoFastRAM or IDE68K

OlegMishin, 2023-06-02:
Hi @krug3rf,
There is some flexibility with the CPLD. You can use ATF1508AS/ASV (TQFP-100) or EPM7128STC100/STI100 with speed grade up to 15ns(which I tested). Also 25ns should work, but I've not tested.
Altera's EPM is much cheaper now. With some luck you can order them in China.
I don't plan to move to Xilinx to not mess with 3.3/5V levels. True 5V CPLD gives more flexibility in adding new functions.
Anyway, there is already "IDE68K + GottaGo FastRAM 8MB" project based on Xilinx.  Maybe it is not open source though.

Regards
Oleg

krug3rf, 2023-06-02:
Thx for advise ;)
About "there is already "IDE68K + GottaGo FastRAM 8MB" project based on Xilinx", I know I have both :;)
But your project is smart and build an "all in one" is better than a PCB sandwitches mode :D :D

OlegMishin, 2023-06-02:
Thanks :)
Have a look at the next version of the project "A500_8MB_ide2". This one doesn't require INT2 and OVR wires.

krug3rf, 2023-06-03:
> Thanks :) Have a look at the next version of the project "A500_8MB_ide2". This one doesn't require INT2 and OVR wires.

Ooohh without INT2 and OVR !
I stay tuned from your futur v2

rmueller83, 2023-06-04:
I found 2 minor mistakes in the BOM:
- J2 is defined as 2mm pitch, but I can only fit a 2.54mm connector
- The LED part numbers are for 1206 LEDs but these are too large to solder properly. I think 0805 is the correct size

Another question: is it preferable to have a straight or an angled IDE connector? I think I saw both variants on the picture.
