OlegMishin/A500_8MB_ide/pcb-rev0/A500_8MB_ide_rev0_SCH.PDF

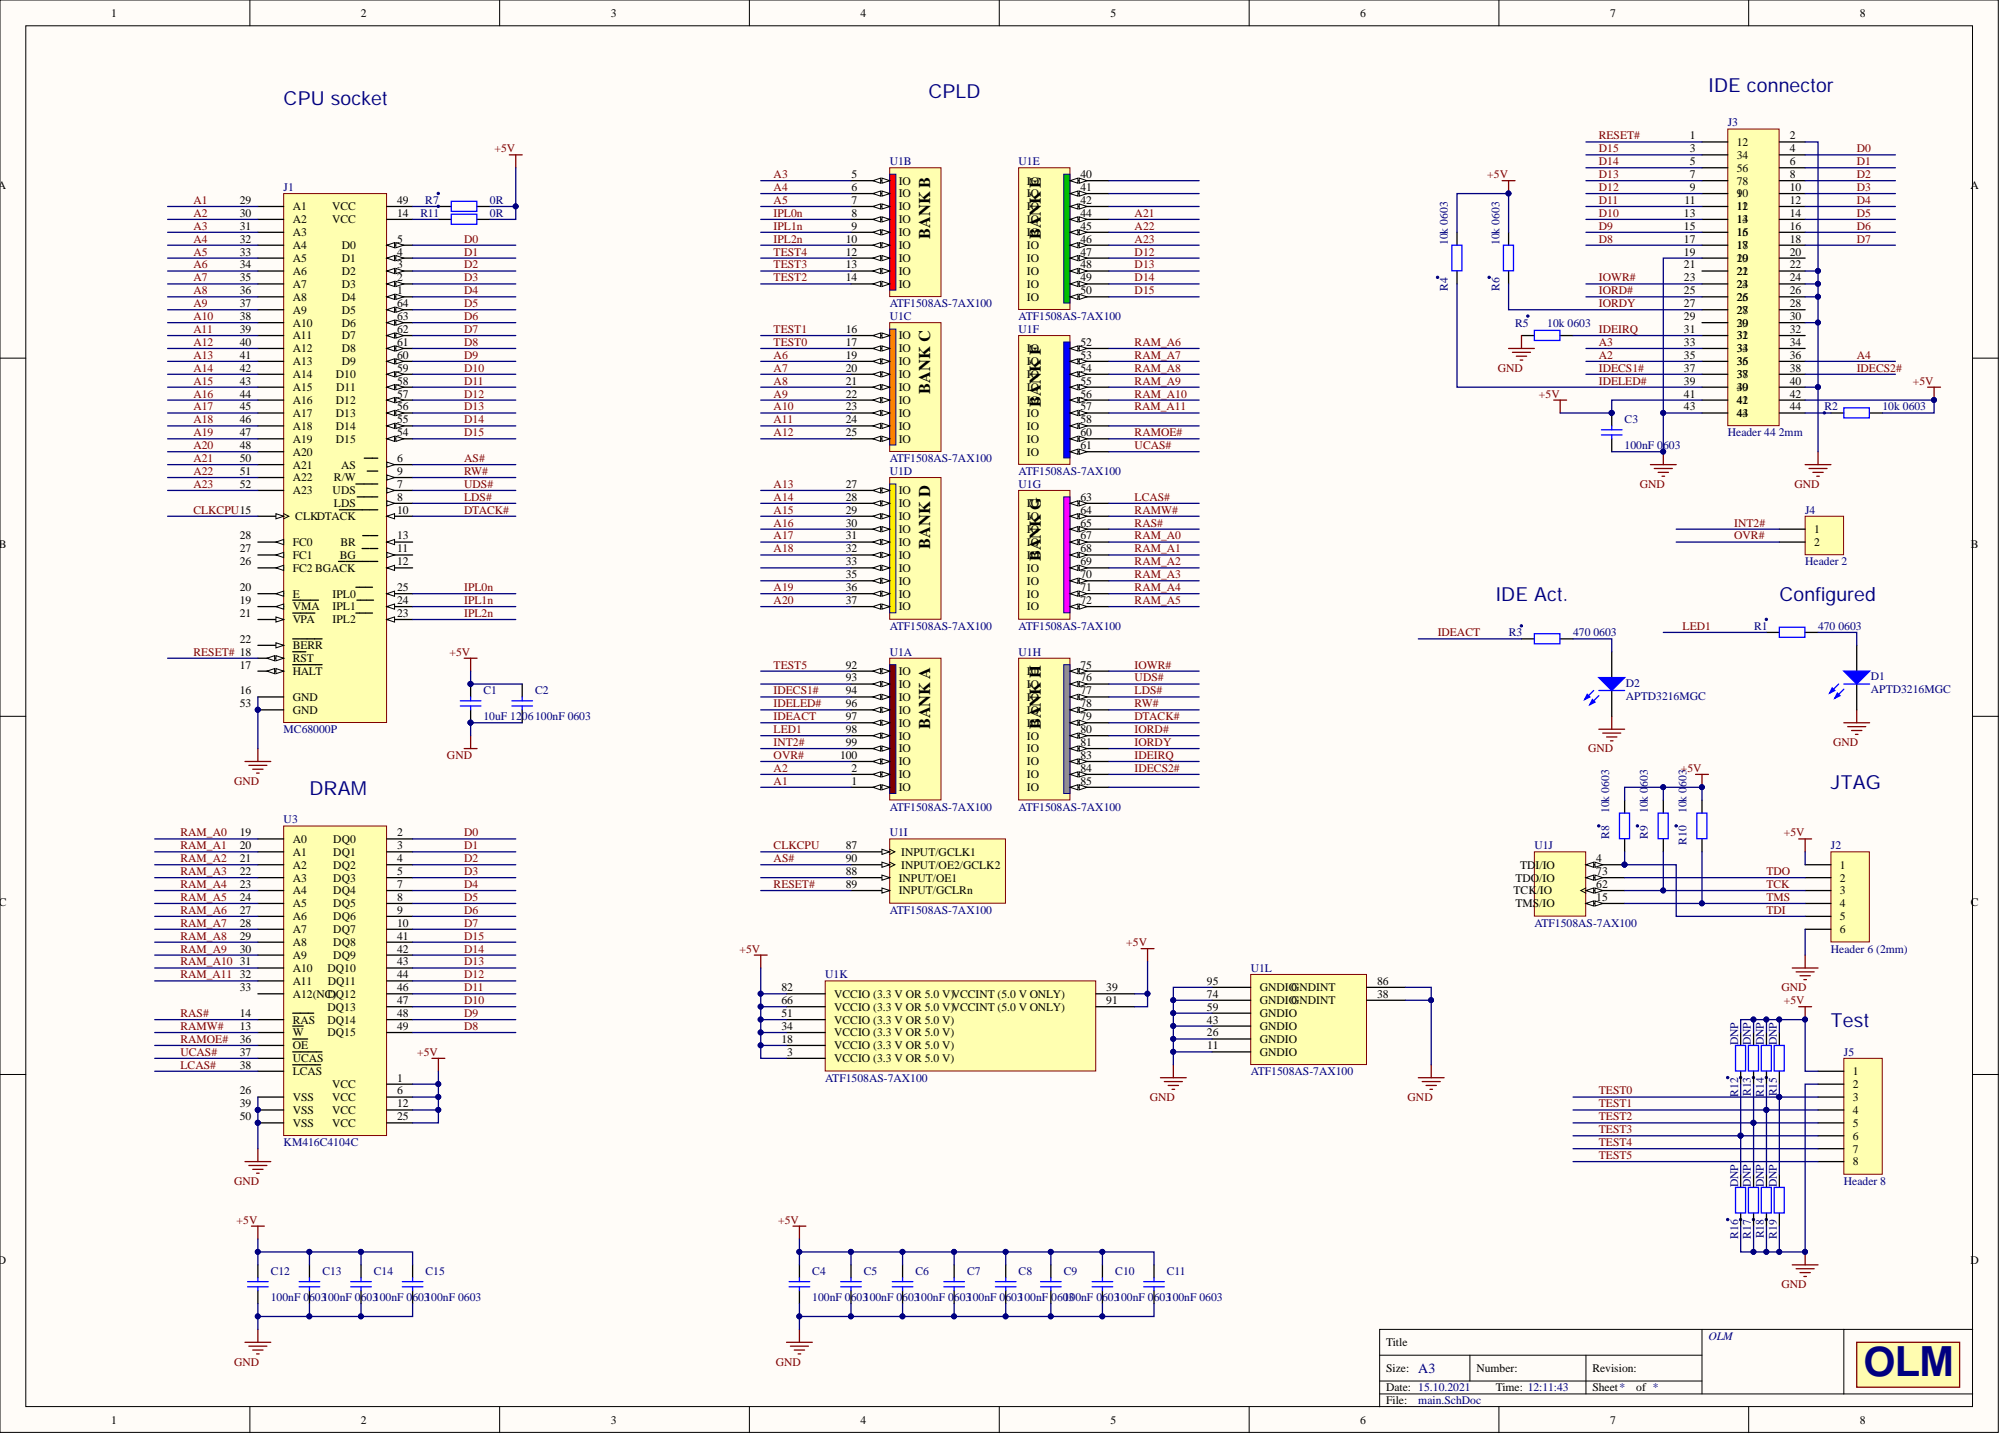
[picture p7: page 1]

Title | OLM

Size: A3 | Number: | Revision:
Date: 15.10.2021 Time: 12:11:43 | | Sheet * of *
