OlegMishin/A500_8MB_ide/(commit log)

2021-10-15 Update README.md
    8MB autoconfig FastRAM and IDE interface expansion board mounted into Amiga's CPU socket.
    Inspired by ram68k and ide68k projects: http://www.mklboards.fi/ram68k/
    Source code based on 68k and A600 "Amiga 600 8 megabytes fastRAM board": http://lvd.nedopc.com/Projects/a600_8mb/index.html
    Autoconfig function based on TF530 sources (Thanks to Stephen J. Leary).
2021-12-03 Add files via upload
    Added Gerber files for production
